ZakKemble/RouterPi/README.md

# RouterPi

Another Raspberry Pi router!

https://blog.zakkemble.net/routerpi-compute-module-4-router/

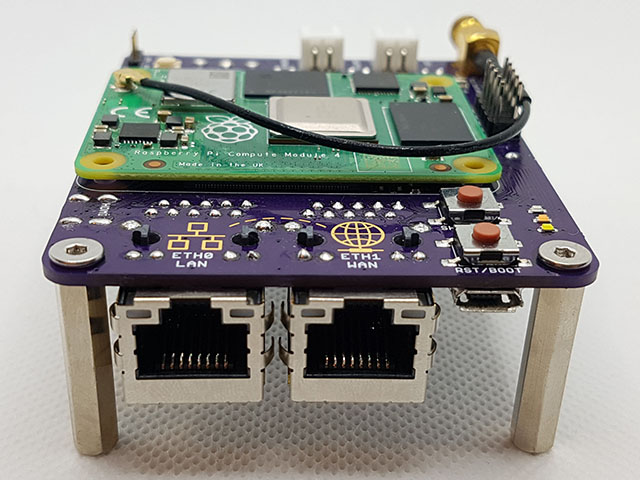
[picture p1: images/routerpi.jpg]
RouterPi pic


--------

Zak Kemble

contact@zakkemble.net
