ZakKemble/RouterPi/hardware/RouterPi_schematic.png

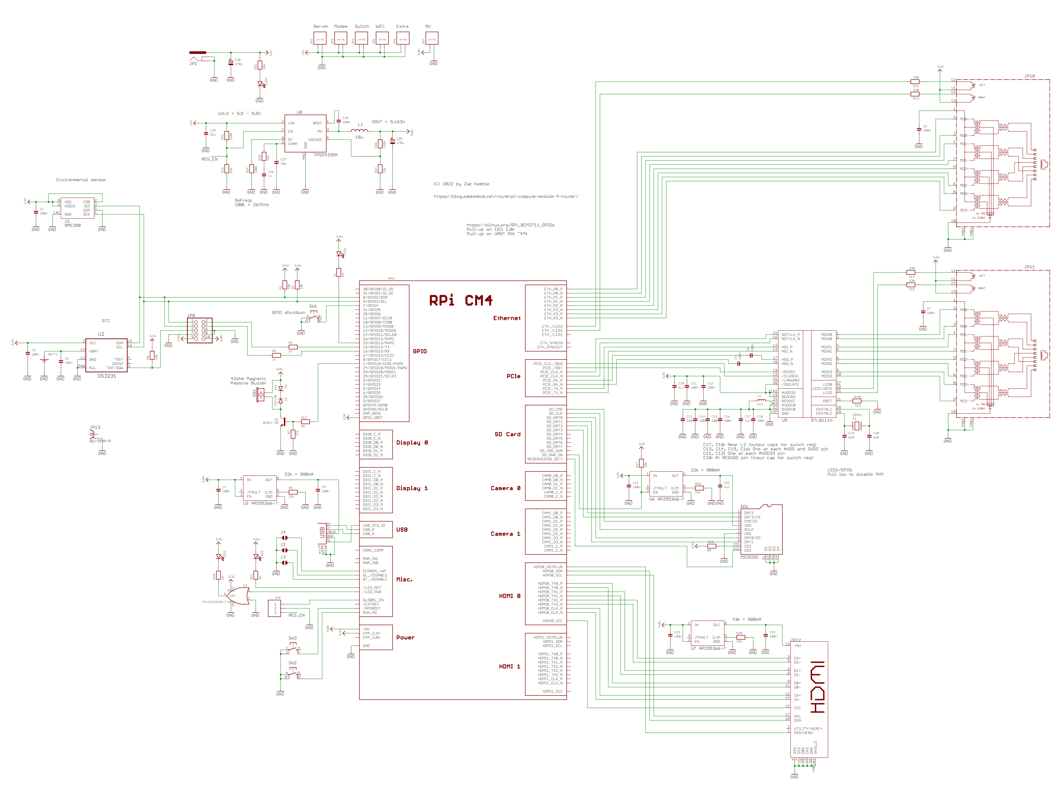
hardware/RouterPi_schematic.png
