ZakKemble/RouterPi/hardware/RouterPi.brd

## EAGLE design hardware/RouterPi.brd (2022-04-19)

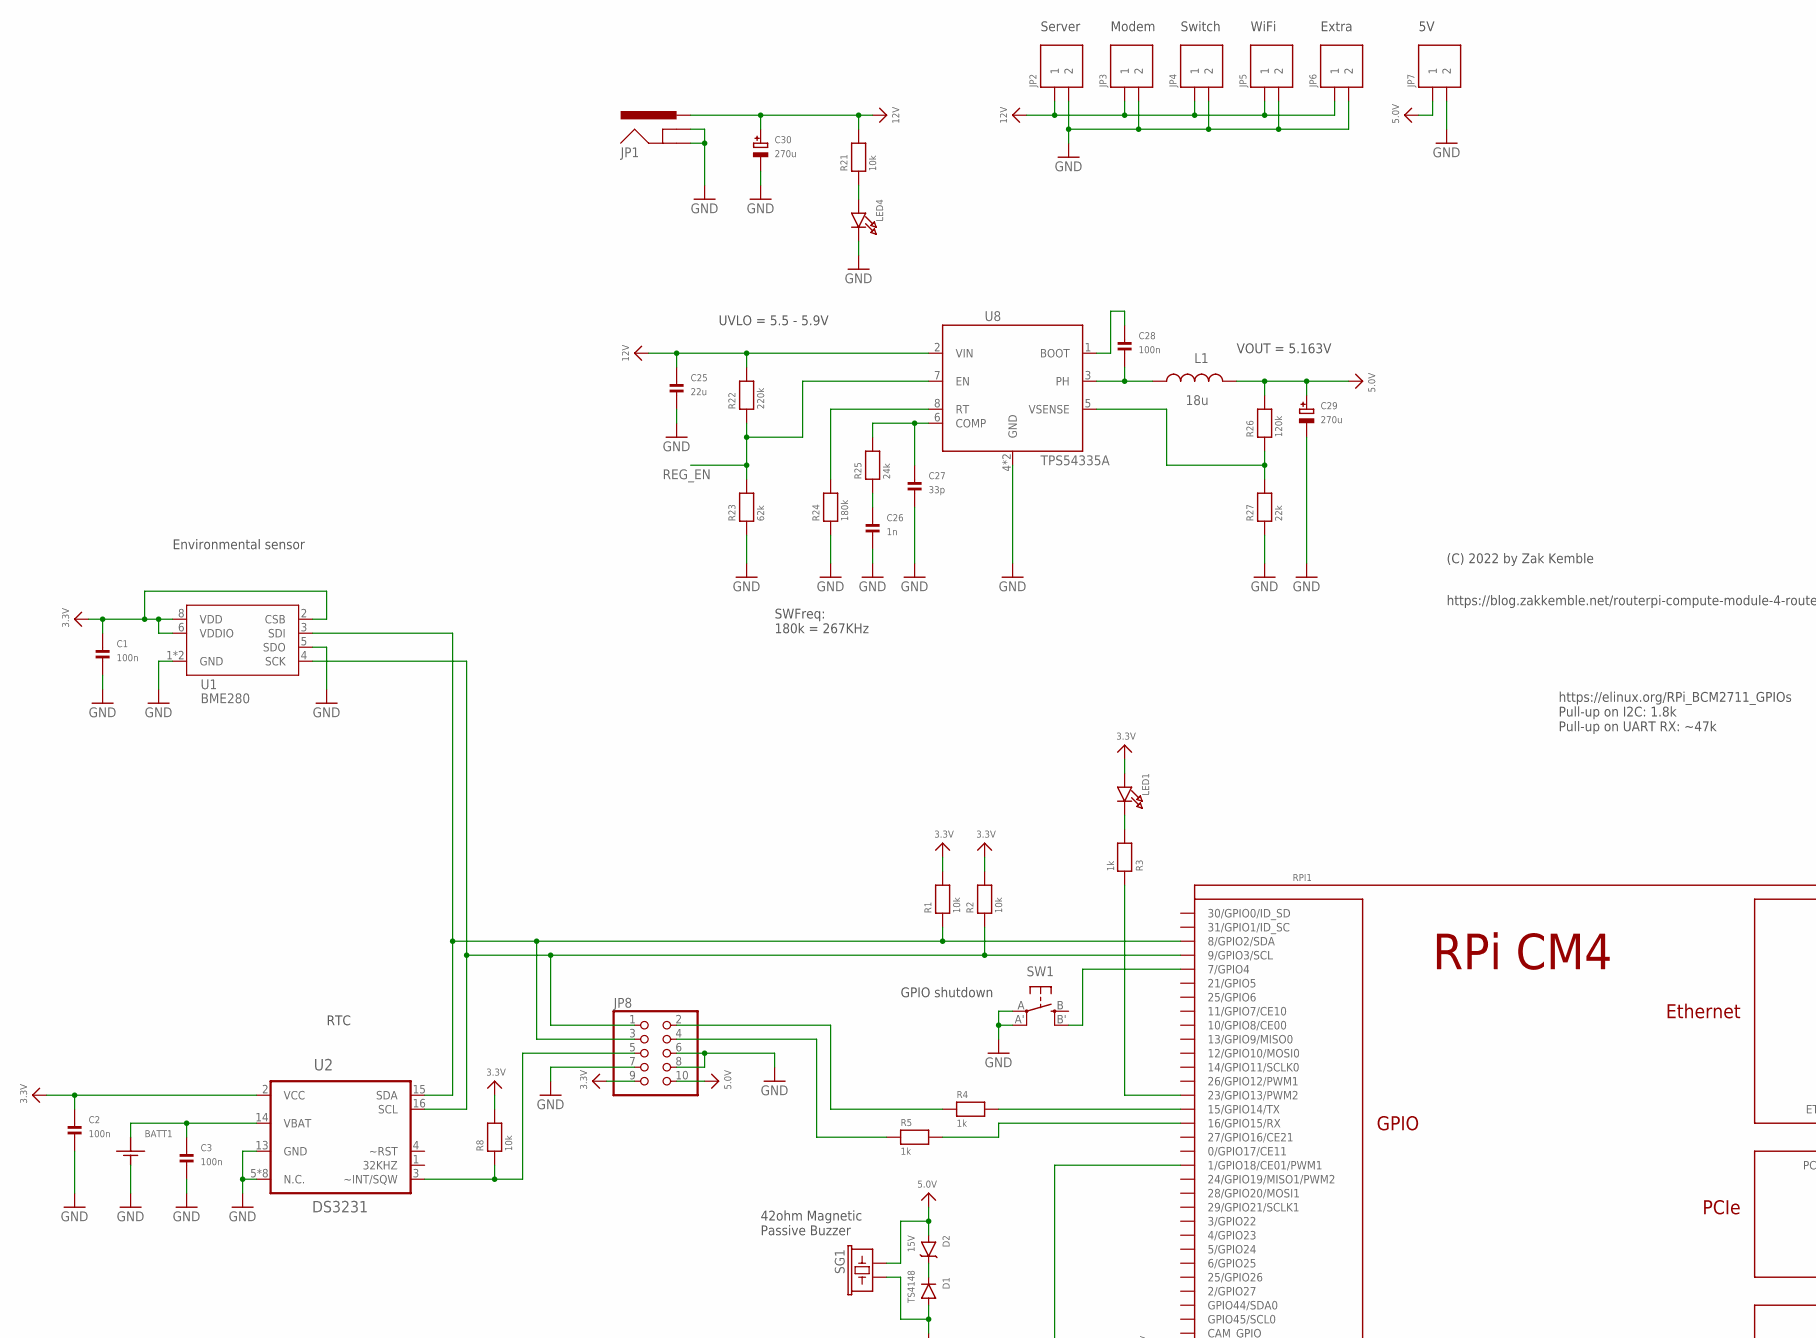
[picture p3: schematic RouterPi.sch, part in row 1, column 1]

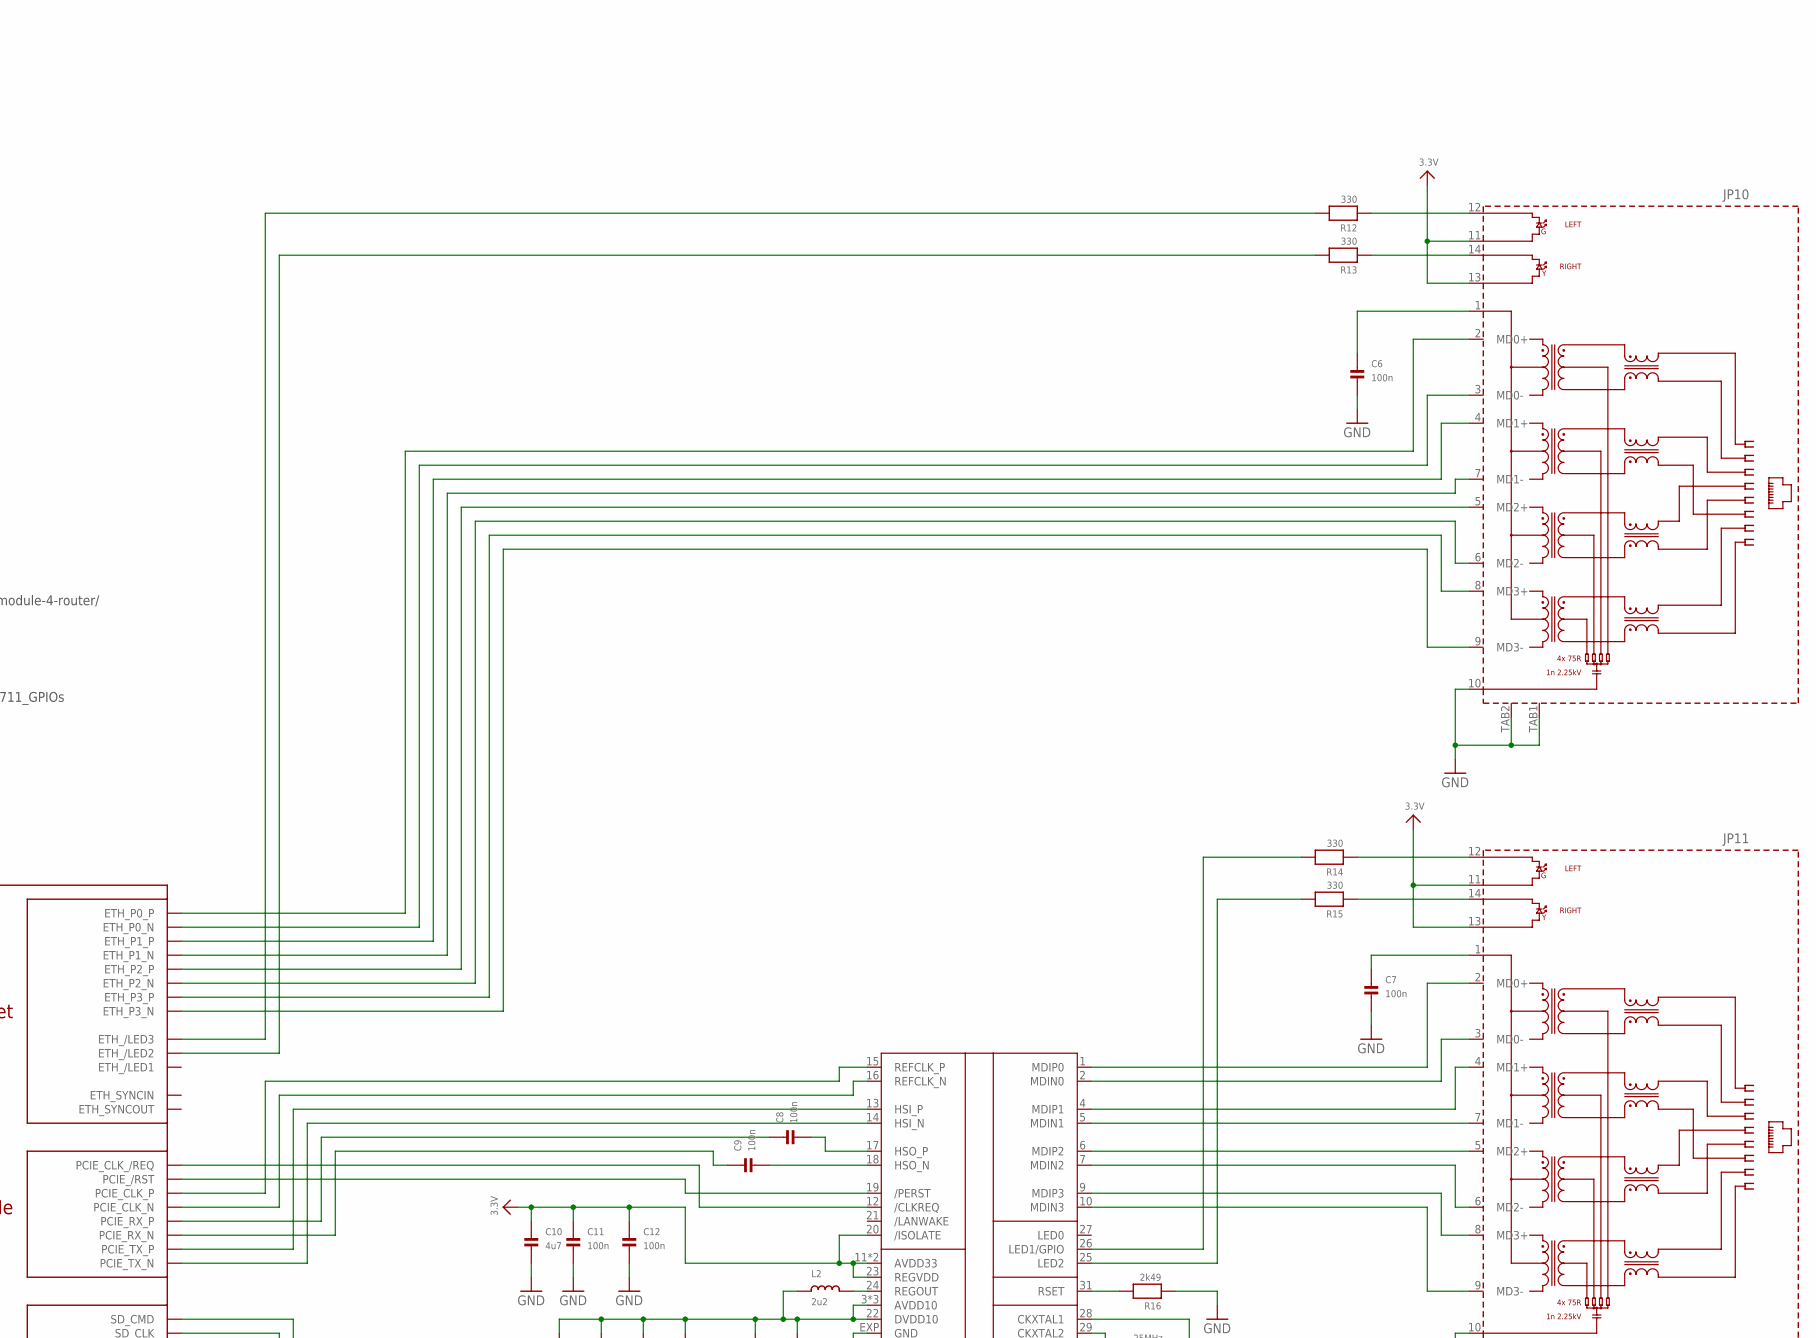
[picture p4: schematic RouterPi.sch, part in row 1, column 2]

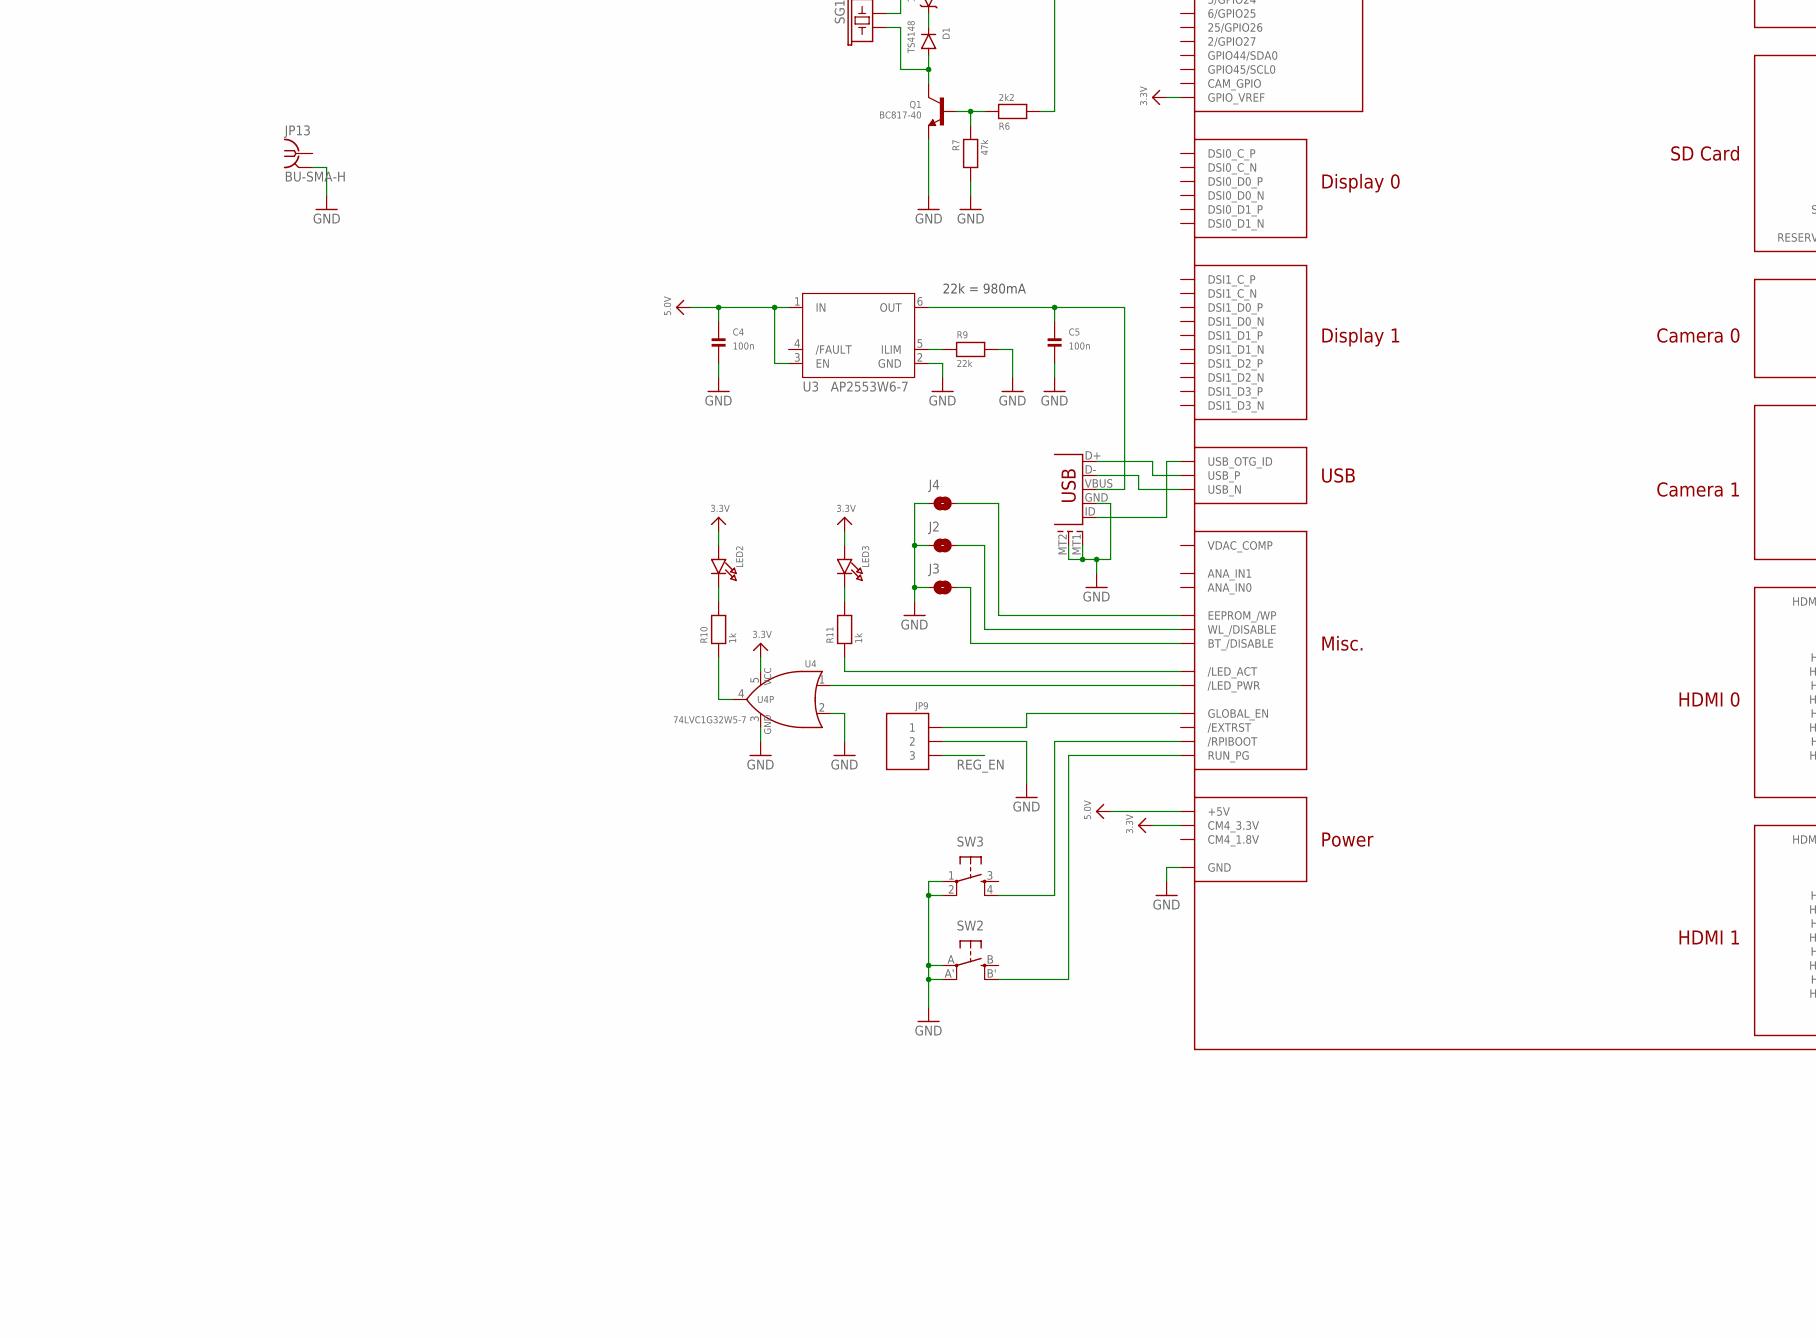
[picture p5: schematic RouterPi.sch, part in row 2, column 1]

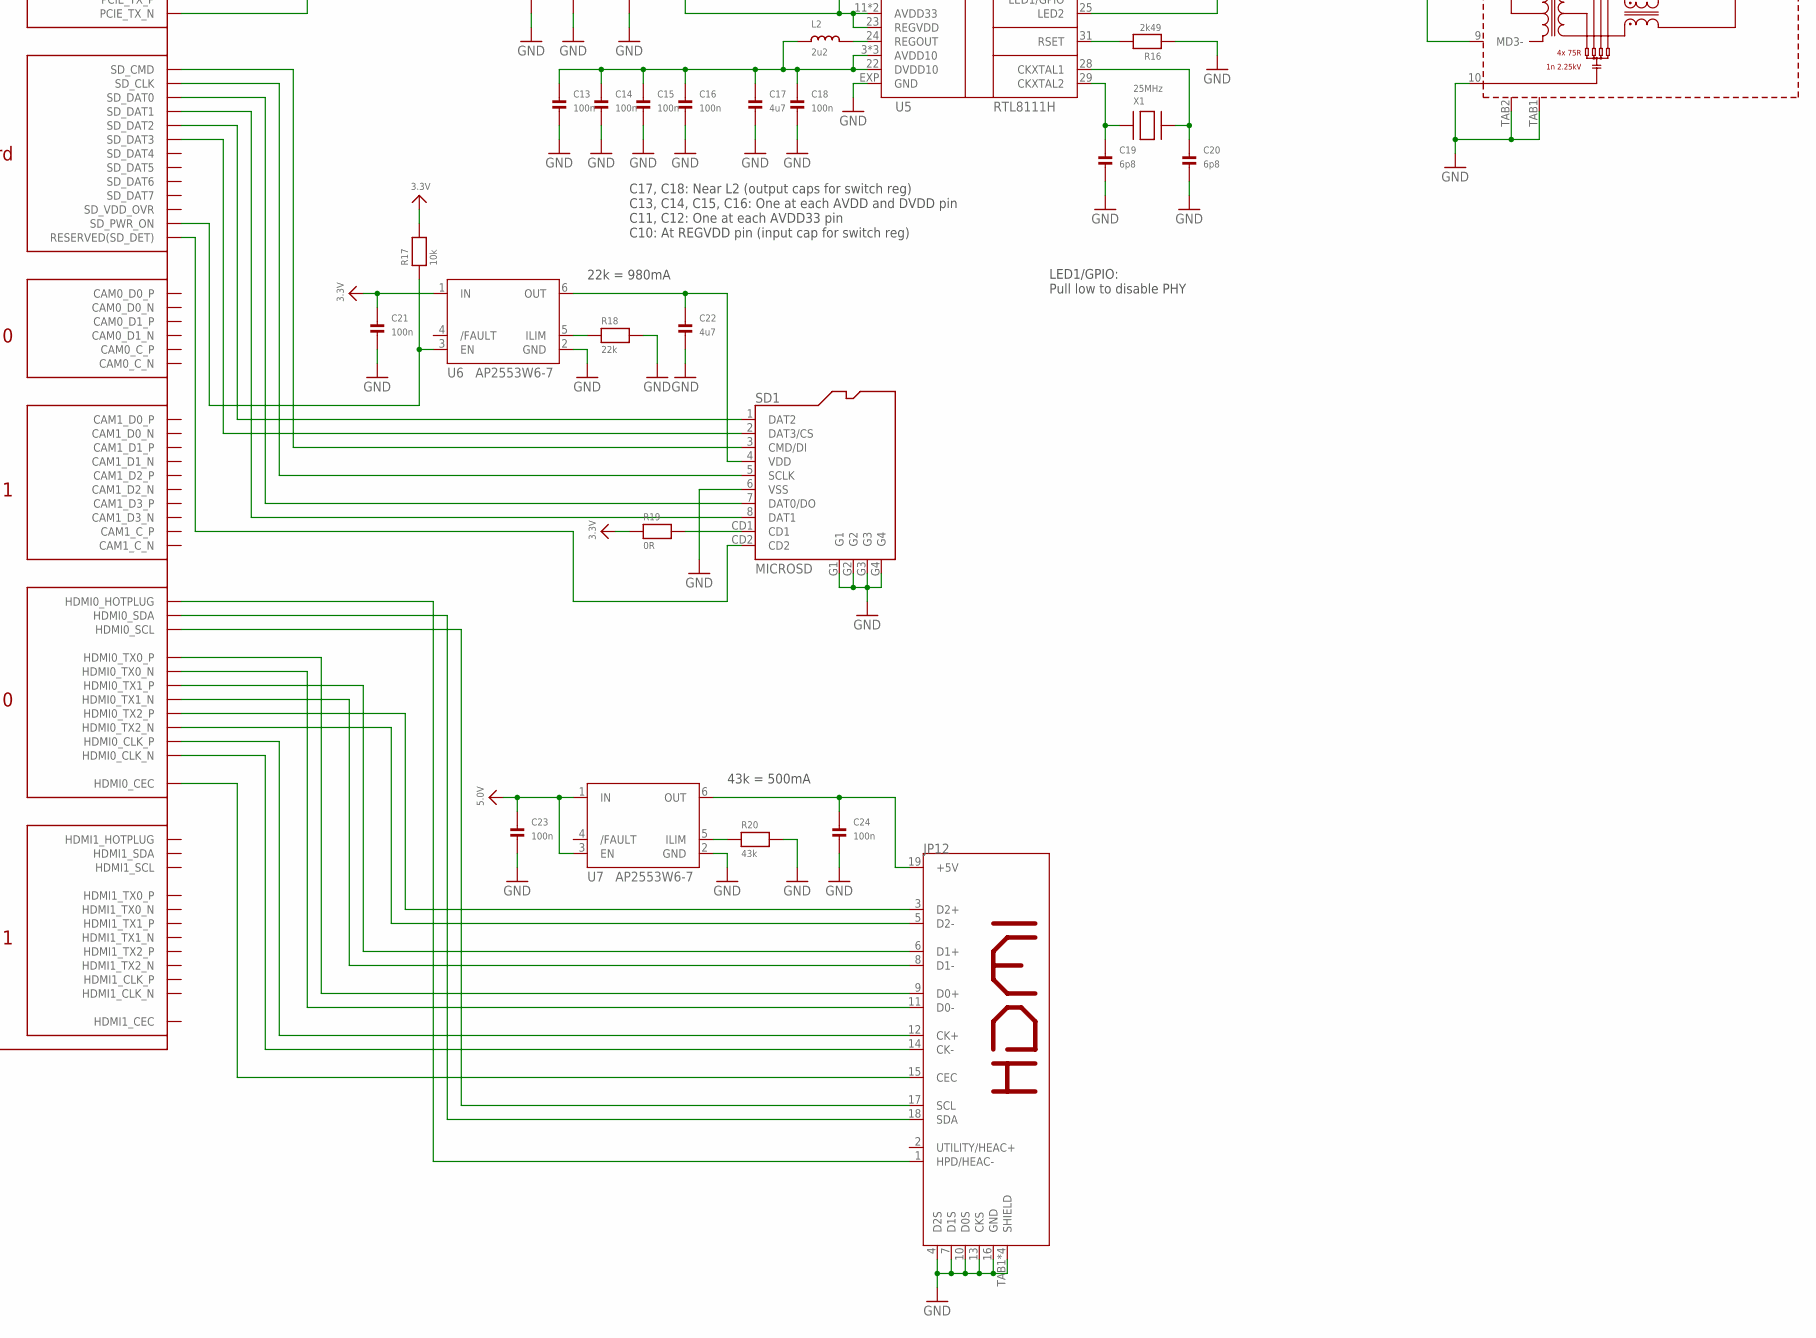
[picture p6: schematic RouterPi.sch, part in row 2, column 2]

Parts:
BATT1: BATTERY_CR927
C1, C2, C3, C4, C5, C6, C7, C8, C9, C11, C12, C13, C14, C15, C16, C18, C21, C23, C24, C28: 100n; 0402_XSMALL
C10, C17: 4u7; _0603MP; FARNELL 2611924
C19, C20: 6p8; 0402_XSMALL
C22: 4u7; _0603MP
C25: 22u; 1210K; PARTNUM C3225X5R1C226M250AA; FARNELL 2526285
C26: 1n; 0402_XSMALL
C27: 33p; 0402_XSMALL
C29, C30: 270u; PANASONIC_D; PARTNUM 16SVPG270M; FARNELL 2491823
D1: TS4148; 0805_DIODE
D2: 15V; SOT-23-SLIMPAD; PARTNUM BZX84-C15
J2, J3, J4: JUMPERSMALL; JUMPER_SMALL
JP1: POWER_JACKPTH_HIGHCURRENT; POWER_JACK_PTH_HIGHCURRENT
JP2, JP3, JP4, JP5, JP6, JP7: 2WAY
JP8: PINHD-2X5; 2X05
JP9: HEADER_3WAY2.0MM; HEADER_2.0_3WAY
JP10, JP11: RJ45_MAG_MOLEX_93626
JP12: HDMIMICRO2; HDMI_MICRO2
JP13: BU-SMA-H
L1: 18u; CDRH125; PARTNUM SRR1210-180M; FARNELL 2408814
L2: 2u2; INDUCTOR_3X3MM_SM; FARNELL 2616857
LED1, LED2, LED3, LED4: LED0603_NOOUTLINE; CHIPLED_0603_NOOUTLINE
Q1: BC817-40; SOT23-R
R1, R2, R8, R17, R21: 10k; 0402_XSMALL
R3, R4, R5, R10, R11: 1k; 0402_XSMALL
R6: 2k2; 0402_XSMALL
R7: 47k; 0402_XSMALL
R9, R18, R27: 22k; 0402_XSMALL
R12, R13, R14, R15: 330; 0402_XSMALL
R16: 2k49; 0402_XSMALL
R19: 0R; 0402_XSMALL
R20: 43k; 0402_XSMALL
R22: 220k; 0402_XSMALL
R23: 62k; 0402_XSMALL
R24: 180k; 0402_XSMALL
R25: 24k; 0402_XSMALL
R26: 120k; 0402_XSMALL
RPI1: RPI_CM4RPI_CM4; RPI_CM4
SD1: MICROSD
SG1: BUZZERPTH; BUZZER-12MM
SW1, SW2: SPST_TACTMC32882; TACT_SMD4
SW3: SPST_TACTG75_3X4; TACT_SMD5
U1: BME280
U2: DS3231; SOIC127P1032X265-16N
U3, U6, U7: AP2553W6-7; SOT23-6_SM_PAD
U4: 74LVC1G32W5-7; SOT23-5_SM_PAD
U5: RTL8111H; QFN32-4X4-0.4
U8: TPS54335A; SOIC8_150MIL_EXPPAD
USB1: USB-MICROBLARGEPAD; USB-MICROB_LARGEPAD
X1: 25MHz; 2016_XTAL; PARTNO MCSJK-7F-25.00-10-20-60-B-20; FARNELL 2853847

Connections:
3.3V: C1.1, C2.1, C10.1, C11.1, C12.1, C21.1, JP8.9, JP10.11 (LED_L_A), JP10.13 (LED_R_A), JP11.11 (LED_L_A), JP11.13 (LED_R_A), LED1.A, LED2.A, LED3.A, R1.2, R2.2, R8.2, R17.2, R19.1, RPI1.78 (GPIO_VREF), RPI1.84 (CM4_3.3V), RPI1.86 (CM4_3.3V), U1.2 (CSB), U1.6 (VDDIO), U1.8 (VDD), U2.2 (VCC), U4.5 (VCC), U5.11 (AVDD33), U5.20 (/ISOLATE), U5.23 (REGVDD), U5.32 (AVDD33), U6.1 (IN)
5.0V: C4.1, C23.1, C29.+, D2.2 (A), JP7.P$1 (1), JP8.10, L1.2, R26.2, RPI1.77 (+5V), RPI1.79 (+5V), RPI1.81 (+5V), RPI1.83 (+5V), RPI1.85 (+5V), RPI1.87 (+5V), SG1.+ (1), U3.1 (IN), U3.3 (EN), U7.1 (IN), U7.3 (EN)
12V: C25.1, C30.+, JP1.PWR, JP2.P$1 (1), JP3.P$1 (1), JP4.P$1 (1), JP5.P$1 (1), JP6.P$1 (1), R21.2, R22.2, U8.2 (VIN)
GND: BATT1.B- (NEG), C1.2, C2.2, C3.2, C4.2, C5.2, C6.2, C7.2, C10.2, C11.2, C12.2, C13.2, C14.2, C15.2, C16.2, C17.2, C18.2, C19.2, C20.2, C21.2, C22.2, C23.2, C24.2, C25.2, C26.2, C27.2, C29.-, C30.-, J2.1, J3.1, J4.1, JP1.C1 (GNDBREAK), JP1.C2 (GNDBREAK), JP1.C3 (GNDBREAK), JP1.C4 (GNDBREAK), JP1.GND, JP2.P$2 (2), JP3.P$2 (2), JP4.P$2 (2), JP5.P$2 (2), JP6.P$2 (2), JP7.P$2 (2), JP8.6, JP8.7, JP8.8, JP9.2, JP10.10 (GND), JP10.TAB1, JP10.TAB2, JP11.10 (GND), JP11.TAB1, JP11.TAB2, JP12.4 (D2S), JP12.7 (D1S), JP12.10 (D0S), JP12.13 (CKS), JP12.16 (GND), JP12.TAB1 (SHIELD), JP12.TAB2 (SHIELD), JP12.TAB3 (SHIELD), JP12.TAB4 (SHIELD), JP13.2, JP13.3 (2), JP13.4 (2), JP13.5 (2), LED4.C, Q1.2 (E), R7.2, R9.2, R16.1, R18.2, R20.2, R23.1, R24.1, R27.1, RPI1.1 (GND), RPI1.2 (GND), RPI1.7 (GND), RPI1.8 (GND), RPI1.13 (GND), RPI1.14 (GND), RPI1.22 (GND), RPI1.23 (GND), RPI1.32 (GND), RPI1.33 (GND), RPI1.42 (GND), RPI1.43 (GND), RPI1.52 (GND), RPI1.53 (GND), RPI1.59 (GND), RPI1.60 (GND), RPI1.65 (GND), RPI1.66 (GND), RPI1.71 (GND), RPI1.74 (GND), RPI1.98 (GND), RPI1.107 (GND), RPI1.108 (GND), RPI1.113 (GND), RPI1.114 (GND), RPI1.119 (GND), RPI1.120 (GND), RPI1.125 (GND), RPI1.126 (GND), RPI1.131 (GND), RPI1.132 (GND), RPI1.137 (GND), RPI1.138 (GND), RPI1.144 (GND), RPI1.150 (GND), RPI1.155 (GND), RPI1.156 (GND), RPI1.161 (GND), RPI1.162 (GND), RPI1.167 (GND), RPI1.168 (GND), RPI1.173 (GND), RPI1.174 (GND), RPI1.179 (GND), RPI1.180 (GND), RPI1.185 (GND), RPI1.186 (GND), RPI1.191 (GND), RPI1.192 (GND), RPI1.197 (GND), RPI1.198 (GND), SD1.6 (VSS), SD1.G1, SD1.G2, SD1.G3, SD1.G4, SW1.A, SW1.A' (P1), SW2.A, SW2.A' (P1), SW3.1, SW3.2 (P1), U1.1 (GND), U1.5 (SDO), U1.7 (GND), U2.5 (N.C.), U2.6 (N.C.), U2.7 (N.C.), U2.8 (N.C.), U2.9 (N.C.), U2.10 (N.C.), U2.11 (N.C.), U2.12 (N.C.), U2.13 (GND), U3.2 (GND), U4.2 (B), U4.3 (GND), U5.EXP (GND), U6.2 (GND), U7.2 (GND), U8.4 (GND), U8.EXPPAD (GND), USB1.GND, USB1.MT1 (SHEILD1), USB1.MT2 (SHEILD2)
unnamed: C28.1, U8.1 (BOOT)
unnamed: R10.1, U4.4 (Y)
unnamed: R24.2, U8.8 (RT)
unnamed: C27.1, R25.2, U8.6 (COMP)
unnamed: C26.1, R25.1
unnamed: JP8.5, R8.1, U2.3 (~INT/SQW)
unnamed: JP12.9 (D0+), RPI1.182 (HDMI0_TX0_P)
unnamed: JP8.3, R1.1, RPI1.58 (8/GPIO2/SDA), U1.3 (SDI), U2.15 (SDA)
unnamed: JP12.11 (D0-), RPI1.184 (HDMI0_TX0_N)
unnamed: JP12.6 (D1+), RPI1.176 (HDMI0_TX1_P)
unnamed: JP12.8 (D1-), RPI1.178 (HDMI0_TX1_N)
unnamed: D1.1 (A), Q1.3 (C), SG1.- (2)
unnamed: C28.2, L1.1, U8.3 (PH)
unnamed: R26.1, R27.2, U8.5 (VSENSE)
unnamed: Q1.1 (B), R6.1, R7.1
unnamed: JP12.3 (D2+), RPI1.170 (HDMI0_TX2_P)
unnamed: J3.2, RPI1.91 (BT_/DISABLE)
unnamed: J2.2, RPI1.89 (WL_/DISABLE)
unnamed: BATT1.B+ (POS), C3.1, U2.14 (VBAT)
unnamed: JP12.5 (D2-), RPI1.172 (HDMI0_TX2_N)
unnamed: JP8.2, R4.1
unnamed: JP12.12 (CK+), RPI1.188 (HDMI0_CLK_P)
unnamed: JP8.1, R2.1, RPI1.56 (9/GPIO3/SCL), U1.4 (SCK), U2.16 (SCL)
unnamed: JP12.14 (CK-), RPI1.190 (HDMI0_CLK_N)
unnamed: R11.1, RPI1.21 (/LED_ACT)
unnamed: RPI1.95 (/LED_PWR), U4.1 (A)
unnamed: JP9.1, RPI1.99 (GLOBAL_EN)
unnamed: RPI1.93 (/RPIBOOT), SW3.4 (S1)
unnamed: LED4.A, R21.1
unnamed: D1.2 (C), D2.1 (C)
unnamed: RPI1.92 (RUN_PG), SW2.B' (S1)
unnamed: L2.P$2 (2), U5.24 (REGOUT)
unnamed: R16.2, U5.31 (RSET)
unnamed: C19.1, U5.29 (CKXTAL2), X1.1
unnamed: C20.1, U5.28 (CKXTAL1), X1.3
unnamed: JP11.2 (MD0+), U5.1 (MDIP0)
unnamed: R15.2, U5.25 (LED2)
unnamed: R14.2, U5.26 (LED1/GPIO)
unnamed: JP11.3 (MD0-), U5.2 (MDIN0)
unnamed: JP11.4 (MD1+), U5.4 (MDIP1)
unnamed: JP11.7 (MD1-), U5.5 (MDIN1)
unnamed: JP11.5 (MD2+), U5.6 (MDIP2)
unnamed: JP11.6 (MD2-), U5.7 (MDIN2)
unnamed: JP11.8 (MD3+), U5.9 (MDIP3)
unnamed: JP11.9 (MD3-), U5.10 (MDIN3)
unnamed: JP8.4, R5.1
unnamed: RPI1.61 (SD_DAT3), SD1.2 (DAT3/CS)
unnamed: C9.2, U5.18 (HSO_N)
unnamed: C8.1, RPI1.116 (PCIE_RX_P)
unnamed: RPI1.62 (SD_CMD), SD1.3 (CMD/DI)
unnamed: RPI1.63 (SD_DAT0), SD1.7 (DAT0/DO)
unnamed: C13.1, C14.1, C15.1, C16.1, C17.1, C18.1, L2.P$1 (1), U5.3 (AVDD10), U5.8 (AVDD10), U5.22 (DVDD10), U5.30 (AVDD10)
unnamed: JP10.12 (LED_L_C), R12.1
unnamed: C7.1, JP11.1 (VCC)
unnamed: C6.1, JP10.1 (VCC)
unnamed: J4.2, RPI1.20 (EEPROM_/WP)
unnamed: JP10.14 (LED_R_C), R13.1
unnamed: C5.1, U3.6 (OUT), USB1.VBUS
unnamed: RPI1.76 (RESERVED(SD_DET)), SD1.CD2
unnamed: JP12.15 (CEC), RPI1.151 (HDMI0_CEC)
unnamed: JP12.17 (SCL), RPI1.200 (HDMI0_SCL)
unnamed: JP12.18 (SDA), RPI1.199 (HDMI0_SDA)
unnamed: JP12.1 (HPD/HEAC-), RPI1.153 (HDMI0_HOTPLUG)
unnamed: R17.1, RPI1.75 (SD_PWR_ON), U6.3 (EN)
unnamed: RPI1.102 (PCIE_CLK_/REQ), U5.12 (/CLKREQ)
unnamed: RPI1.103 (USB_N), USB1.D-
unnamed: RPI1.105 (USB_P), USB1.D+
unnamed: RPI1.101 (USB_OTG_ID), USB1.ID
unnamed: RPI1.109 (PCIE_/RST), U5.19 (/PERST)
unnamed: RPI1.110 (PCIE_CLK_P), U5.15 (REFCLK_P)
unnamed: RPI1.112 (PCIE_CLK_N), U5.16 (REFCLK_N)
unnamed: C8.2, U5.17 (HSO_P)
unnamed: C9.1, RPI1.118 (PCIE_RX_N)
unnamed: RPI1.122 (PCIE_TX_P), U5.13 (HSI_P)
unnamed: RPI1.124 (PCIE_TX_N), U5.14 (HSI_N)
unnamed: JP10.2 (MD0+), RPI1.12 (ETH_P0_P)
unnamed: JP10.3 (MD0-), RPI1.10 (ETH_P0_N)
unnamed: JP10.4 (MD1+), RPI1.4 (ETH_P1_P)
unnamed: JP10.7 (MD1-), RPI1.6 (ETH_P1_N)
unnamed: JP10.5 (MD2+), RPI1.11 (ETH_P2_P)
unnamed: JP10.6 (MD2-), RPI1.9 (ETH_P2_N)
unnamed: JP10.8 (MD3+), RPI1.3 (ETH_P3_P)
unnamed: JP10.9 (MD3-), RPI1.5 (ETH_P3_N)
unnamed: C24.1, JP12.19 (+5V), U7.6 (OUT)
unnamed: C22.1, SD1.4 (VDD), U6.6 (OUT)
unnamed: R6.2, RPI1.49 (1/GPIO18/CE01/PWM1)
unnamed: RPI1.54 (7/GPIO4), SW1.B' (S1)
unnamed: JP11.12 (LED_L_C), R14.1
unnamed: JP11.14 (LED_R_C), R15.1
unnamed: R4.2, RPI1.55 (15/GPIO14/TX)
unnamed: R5.2, RPI1.51 (16/GPIO15/RX)
unnamed: R12.2, RPI1.15 (ETH_/LED3)
unnamed: R13.2, RPI1.17 (ETH_/LED2)
unnamed: RPI1.67 (SD_DAT1), SD1.8 (DAT1)
unnamed: RPI1.57 (SD_CLK), SD1.5 (SCLK)
unnamed: RPI1.69 (SD_DAT2), SD1.1 (DAT2)
unnamed: R3.1, RPI1.28 (23/GPIO13/PWM2)
unnamed: R9.1, U3.5 (ILIM)
unnamed: R20.1, U7.5 (ILIM)
unnamed: LED1.C, R3.2
unnamed: LED3.C, R11.2
unnamed: R18.1, U6.5 (ILIM)
unnamed: R19.2, SD1.CD1
unnamed: LED2.C, R10.2
REG_EN: JP9.3, R22.1, R23.2, U8.7 (EN)

Notes on the sheet:
(C) 2022 by Zak Kemble
GPIO shutdown
https://elinux.org/RPi_BCM2711_GPIOs Pull-up on I2C: 1.8k Pull-up on UART RX: ~47k
C17, C18: Near L2 (output caps for switch reg) C13, C14, C15, C16: One at each AVDD and DVDD pin C11, C12: One at each AVDD33 pin C10: At REGVDD pin (input cap for switch reg)
22k = 980mA
43k = 500mA
UVLO = 5.5 - 5.9V
SWFreq: 180k = 267KHz
Server
Modem
Switch
WiFi
Extra
42ohm Magnetic Passive Buzzer
VOUT = 5.163V
LED1/GPIO: Pull low to disable PHY
RTC
Environmental sensor
https://blog.zakkemble.net/routerpi-compute-module-4-router/

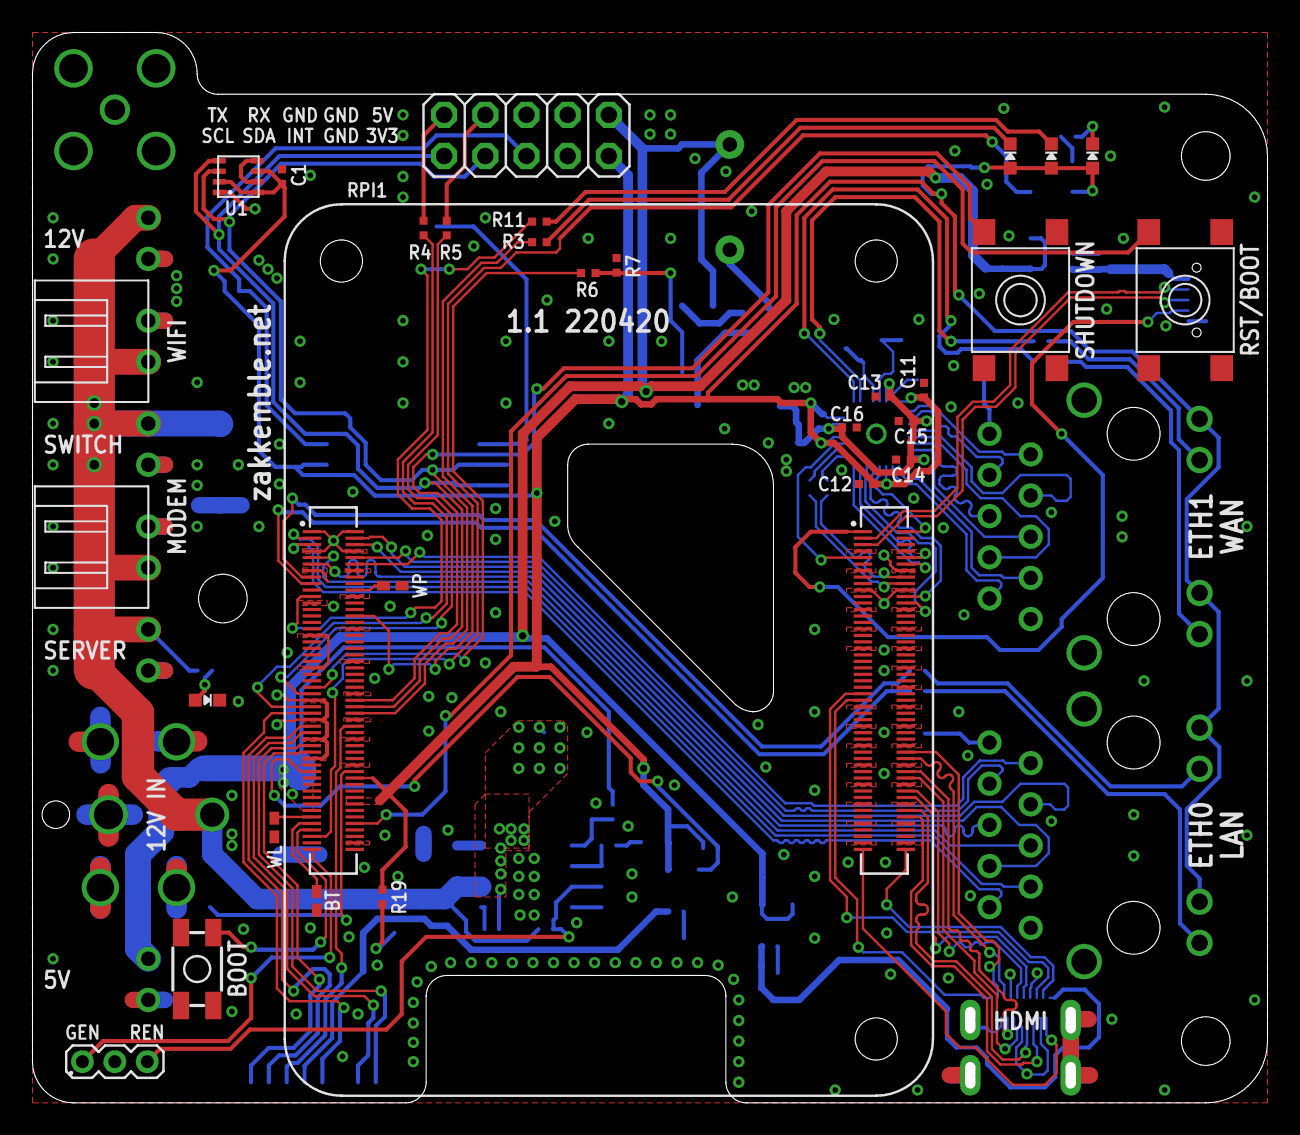
[picture p7: board RouterPi.brd from above]

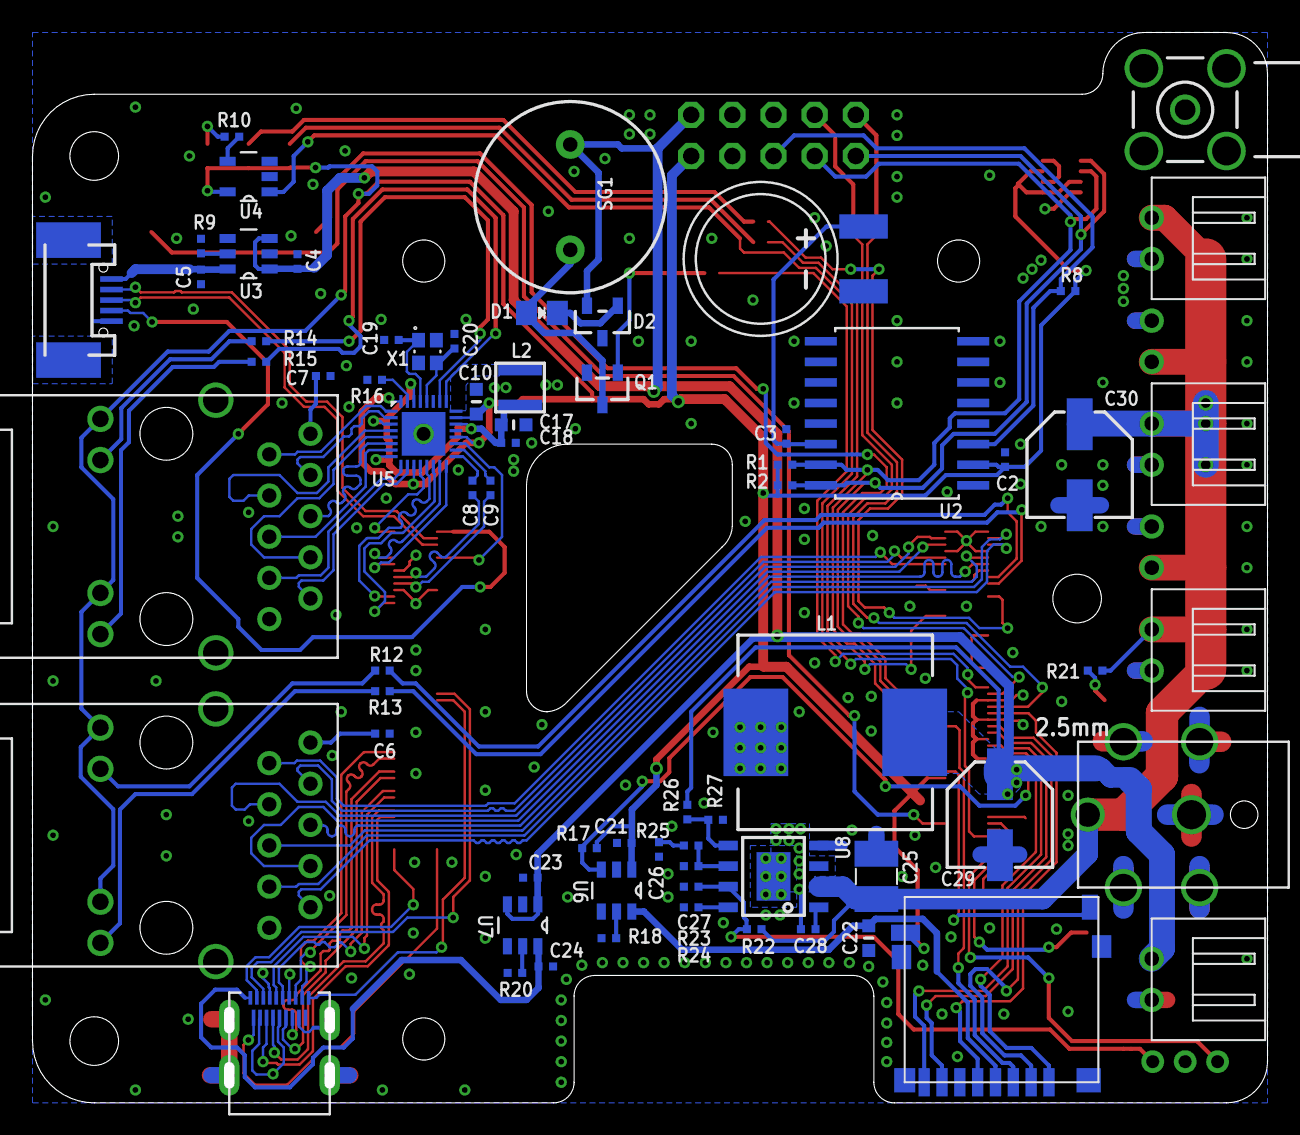
[picture p8: board RouterPi.brd from below]

Board: 2 copper layers, 76.2 x 66.0 mm, 99 parts (69 on the bottom side), 109 nets.
