ZakKemble/RouterPi/configs/boot/config.txt

# For more options and information see
# http://rpf.io/configtxt
# Some settings may impact device functionality. See link above for details

# uncomment if you get no picture on HDMI for a default "safe" mode
#hdmi_safe=1

# uncomment the following to adjust overscan. Use positive numbers if console
# goes off screen, and negative if there is too much border
#overscan_left=16
#overscan_right=16
#overscan_top=16
#overscan_bottom=16

# uncomment to force a console size. By default it will be display's size minus
# overscan.
#framebuffer_width=1280
#framebuffer_height=720

# uncomment if hdmi display is not detected and composite is being output
#hdmi_force_hotplug=1

# uncomment to force a specific HDMI mode (this will force VGA)
#hdmi_group=1
#hdmi_mode=1

# uncomment to force a HDMI mode rather than DVI. This can make audio work in
# DMT (computer monitor) modes
#hdmi_drive=2

# uncomment to increase signal to HDMI, if you have interference, blanking, or
# no display
#config_hdmi_boost=4

# uncomment for composite PAL
#sdtv_mode=2

#uncomment to overclock the arm. 700 MHz is the default.
#arm_freq=800

# Uncomment some or all of these to enable the optional hardware interfaces
#dtparam=i2c_arm=on
#dtparam=i2s=on
#dtparam=spi=on

# Uncomment this to enable infrared communication.
#dtoverlay=gpio-ir,gpio_pin=17
#dtoverlay=gpio-ir-tx,gpio_pin=18

# Additional overlays and parameters are documented /boot/overlays/README

# Enable audio (loads snd_bcm2835)
dtparam=audio=on

# Automatically load overlays for detected cameras
camera_auto_detect=1

# Automatically load overlays for detected DSI displays
display_auto_detect=1

# Enable DRM VC4 V3D driver
dtoverlay=vc4-kms-v3d
max_framebuffers=2

# Run in 64-bit mode
arm_64bit=1

# Disable compensation for displays with overscan
disable_overscan=1


# Speedup the boot process
force_eeprom_read=0
disable_poe_fan=1
boot_delay=0
initial_turbo=10
start_cd=1

# Reduce GPU frequency to save power
# core_freq_min and gpu_freq_min are the only options that seem to have any effect on idle power consumption
core_freq_min=60
gpu_freq_min=60

# https://github.com/raspberrypi/firmware/blob/master/boot/overlays/README

# Disable bluetooth
dtoverlay=disable-bt

# Enable I2C for BME280 sensor and DS3231 RTC
dtparam=i2c_vc=on
dtoverlay=i2c1
dtoverlay=i2c-sensor,bme280,addr=0x76
dtoverlay=i2c-rtc,ds3231

# Shutdown button
dtoverlay=gpio-shutdown,gpio_pin=4

# Use external WiFi antenna
dtparam=ant2

# Setting 'pwr_led_trigger' to 'cpu' causes excessive CPU usage, but using 'act_led_trigger' works fine
# 'cpu' doesn't work with 64-bit kernel https://github.com/raspberrypi/linux/issues/4425
dtparam=act_led_trigger=cpu
dtparam=pwr_led_trigger=mmc0

# https://diode.io/raspberry%20pi/running-forever-with-the-raspberry-pi-hardware-watchdog-20202/
#dtparam=watchdog=on

# Set GPU memory to 32MB
# Can go down to 16MB, but some errors will appear in dmesg during boot. They're not a problem, though.
gpu_mem=32
#hdmi_enable_4kp60=1

[cm4]
# Enable host mode on the 2711 built-in XHCI USB controller.
# This line should be removed if the legacy DWC2 controller is required
# (e.g. for USB device mode) or if USB support is not required.
otg_mode=1

[all]

[pi4]
# Run as fast as firmware / board allows
arm_boost=1

[all]
