ZakKemble/RouterPi/(commit log)

2022-04-19 Add schematic and PCB designs
    [RouterPi.brd, RouterPi.sch]
2022-04-19 config.txt: add default config
    [config.txt]
2022-04-20 script: show temperatures
2022-04-20 config.txt: configure
    [config.txt]
2022-08-17 script: enable interrupt coalescing
